diamondhollins7/cy68013-stm32-gpif-bridge/16-buses/hardware/FX2_STM32_GPIF_Bridge_Netlist.csv

Net | Ref | Pin | PinName
+3V3 | C13 | 1 | 1
+3V3 | C14 | 1 | 1
+3V3 | C15 | 1 | 1
+3V3 | C16 | 1 | 1
+3V3 | C17 | 1 | 1
+3V3 | C18 | 1 | 1
+3V3 | C19 | 1 | 1
+3V3 | C2 | 1 | 1
+3V3 | C20 | 1 | 1
+3V3 | C3 | 1 | 1
+3V3 | C33 | 1 | 1
+3V3 | C34 | 1 | 1
+3V3 | C35 | 1 | 1
+3V3 | C36 | 1 | 1
+3V3 | C37 | 1 | 1
+3V3 | C38 | 1 | 1
+3V3 | C39 | 1 | 1
+3V3 | FB2 | 1 | 1
+3V3 | FB3 | 1 | 1
+3V3 | J2 | 1 | VTref
+3V3 | JP2 | 1 | 1
+3V3 | R10 | 1 | 1
+3V3 | R11 | 1 | 1
+3V3 | R13 | 1 | 1
+3V3 | R14 | 1 | 1
+3V3 | R15 | 1 | 1
+3V3 | R2 | 1 | 1
+3V3 | R30 | 1 | 1
+3V3 | R50 | 1 | 1
+3V3 | R51 | 1 | 1
+3V3 | R52 | 1 | 1
+3V3 | TP2 | 1 | 1
+3V3 | U1 | 6 | VCC
+3V3 | U1 | 18 | VCC
+3V3 | U1 | 24 | VCC
+3V3 | U1 | 34 | VCC
+3V3 | U1 | 39 | VCC
+3V3 | U1 | 50 | VCC
+3V3 | U2 | 1 | A0
+3V3 | U2 | 8 | VCC
+3V3 | U3 | 2 | VOUT
+3V3 | U3 | 4 | TAB
+3V3 | U5 | 6 | VBAT
+3V3 | U5 | 11 | VDD_5
+3V3 | U5 | 28 | VDD_4
+3V3 | U5 | 50 | VDD_1
+3V3 | U5 | 75 | VDD_2
+3V3 | U5 | 100 | VDD_3
+3V3_FXA | C21 | 1 | 1
+3V3_FXA | C22 | 1 | 1
+3V3_FXA | C23 | 1 | 1
+3V3_FXA | FB2 | 2 | 2
+3V3_FXA | U1 | 10 | AVCC
+3V3_FXA | U1 | 14 | AVCC
+3V3_STA | C40 | 1 | 1
+3V3_STA | C41 | 1 | 1
+3V3_STA | FB3 | 2 | 2
+3V3_STA | U5 | 21 | VREF+
+3V3_STA | U5 | 22 | VDDA
+5V | C1 | 1 | 1
+5V | FB1 | 2 | 2
+5V | TP1 | 1 | 1
+5V | U3 | 3 | VIN
EE_SDA | JP1 | 2 | 2
EE_SDA | U2 | 5 | SDA
FD0 | RN1 | 1 | 1
FD0 | U1 | 25 | PB0/FD0
FD1 | RN1 | 2 | 2
FD1 | U1 | 26 | PB1/FD1
FD10 | RN3 | 3 | 3
FD10 | U1 | 54 | PD2/FD10
FD11 | RN3 | 4 | 4
FD11 | U1 | 55 | PD3/FD11
FD12 | RN4 | 1 | 1
FD12 | U1 | 56 | PD4/FD12
FD13 | RN4 | 2 | 2
FD13 | U1 | 1 | PD5/FD13
FD14 | RN4 | 3 | 3
FD14 | U1 | 2 | PD6/FD14
FD15 | RN4 | 4 | 4
FD15 | U1 | 3 | PD7/FD15
FD2 | RN1 | 3 | 3
FD2 | U1 | 27 | PB2/FD2
FD3 | RN1 | 4 | 4
FD3 | U1 | 28 | PB3/FD3
FD4 | RN2 | 1 | 1
FD4 | U1 | 29 | PB4/FD4
FD5 | RN2 | 2 | 2
FD5 | U1 | 30 | PB5/FD5
FD6 | RN2 | 3 | 3
FD6 | U1 | 31 | PB6/FD6
FD7 | RN2 | 4 | 4
FD7 | U1 | 32 | PB7/FD7
FD8 | RN3 | 1 | 1
FD8 | U1 | 52 | PD0/FD8
FD9 | RN3 | 2 | 2
FD9 | U1 | 53 | PD1/FD9
FX_CLKOUT | TP11 | 1 | 1
FX_CLKOUT | U1 | 5 | CLKOUT
FX_IFCLK | R12 | 1 | 1
FX_IFCLK | TP10 | 1 | 1
FX_IFCLK | U1 | 20 | IFCLK
FX_LED_A | D2 | A | A
FX_LED_A | R15 | 2 | 2
FX_LED_N | D2 | K | K
FX_LED_N | U1 | 41 | PA1/INT1#
FX_RESET_N | C12 | 1 | 1
FX_RESET_N | R10 | 2 | 2
FX_RESET_N | SW1 | 1 | 1
FX_RESET_N | U1 | 49 | RESET#
FX_WAKEUP | R11 | 2 | 2
FX_WAKEUP | U1 | 51 | WAKEUP
FX_XI | C10 | 1 | 1
FX_XI | U1 | 12 | XTALIN
FX_XI | Y1 | 1 | 1
FX_XO | C11 | 1 | 1
FX_XO | U1 | 11 | XTALOUT
FX_XO | Y1 | 2 | 2
GD0 | RN1 | 8 | 8
GD0 | U5 | 97 | PE0 D0
GD1 | RN1 | 7 | 7
GD1 | U5 | 98 | PE1 D1
GD10 | RN3 | 6 | 6
GD10 | U5 | 41 | PE10 D10
GD11 | RN3 | 5 | 5
GD11 | U5 | 42 | PE11 D11
GD12 | RN4 | 8 | 8
GD12 | U5 | 43 | PE12 D12
GD13 | RN4 | 7 | 7
GD13 | U5 | 44 | PE13 D13
GD14 | RN4 | 6 | 6
GD14 | U5 | 45 | PE14 D14
GD15 | RN4 | 5 | 5
GD15 | U5 | 46 | PE15 D15
GD2 | RN1 | 6 | 6
GD2 | U5 | 1 | PE2 D2
GD3 | RN1 | 5 | 5
GD3 | U5 | 2 | PE3 D3
GD4 | RN2 | 8 | 8
GD4 | U5 | 3 | PE4 D4
GD5 | RN2 | 7 | 7
GD5 | U5 | 4 | PE5 D5
GD6 | RN2 | 6 | 6
GD6 | U5 | 5 | PE6 D6
GD7 | RN2 | 5 | 5
GD7 | U5 | 38 | PE7 D7
GD8 | RN3 | 8 | 8
GD8 | U5 | 39 | PE8 D8
GD9 | RN3 | 7 | 7
GD9 | U5 | 40 | PE9 D9
GND | C1 | 2 | 2
GND | C10 | 2 | 2
GND | C11 | 2 | 2
GND | C12 | 2 | 2
GND | C13 | 2 | 2
GND | C14 | 2 | 2
GND | C15 | 2 | 2
GND | C16 | 2 | 2
GND | C17 | 2 | 2
GND | C18 | 2 | 2
GND | C19 | 2 | 2
GND | C2 | 2 | 2
GND | C20 | 2 | 2
GND | C21 | 2 | 2
GND | C22 | 2 | 2
GND | C23 | 2 | 2
GND | C3 | 2 | 2
GND | C30 | 2 | 2
GND | C31 | 2 | 2
GND | C32 | 2 | 2
GND | C33 | 2 | 2
GND | C34 | 2 | 2
GND | C35 | 2 | 2
GND | C36 | 2 | 2
GND | C37 | 2 | 2
GND | C38 | 2 | 2
GND | C39 | 2 | 2
GND | C4 | 2 | 2
GND | C40 | 2 | 2
GND | C41 | 2 | 2
GND | D1 | K | K
GND | D4 | K | K
GND | D5 | K | K
GND | J1 | 5 | GND
GND | J2 | 3 | GND
GND | J3 | 1 | GND
GND | J4 | 6 | GND
GND | R1 | 2 | 2
GND | R12 | 2 | 2
GND | R31 | 2 | 2
GND | R32 | 2 | 2
GND | R53 | 2 | 2
GND | R54 | 2 | 2
GND | SW1 | 2 | 2
GND | SW2 | 2 | 2
GND | TP3 | 1 | 1
GND | U1 | 4 | GND
GND | U1 | 7 | GND
GND | U1 | 13 | AGND
GND | U1 | 17 | AGND
GND | U1 | 19 | GND
GND | U1 | 21 | RESERVED
GND | U1 | 33 | GND
GND | U1 | 35 | GND
GND | U1 | 48 | GND
GND | U2 | 2 | A1
GND | U2 | 3 | A2
GND | U2 | 4 | VSS
GND | U2 | 7 | WP
GND | U3 | 1 | GND
GND | U4 | 2 | GND
GND | U5 | 10 | VSS_5
GND | U5 | 19 | VSSA
GND | U5 | 20 | VREF-
GND | U5 | 27 | VSS_4
GND | U5 | 49 | VSS_1
GND | U5 | 74 | VSS_2
GND | U5 | 99 | VSS_3
GPIF_ACK | J4 | 3 | ACK
GPIF_ACK | R53 | 1 | 1
GPIF_ACK | U1 | 8 | RDY0
GPIF_ACK | U5 | 17 | PC2 ACK
GPIF_DAV | J4 | 4 | DAV
GPIF_DAV | R54 | 1 | 1
GPIF_DAV | U1 | 9 | RDY1
GPIF_DAV | U5 | 18 | PC3 DAV
GPIF_NRD | J4 | 2 | nRD
GPIF_NRD | R51 | 2 | 2
GPIF_NRD | U1 | 37 | CTL1
GPIF_NRD | U5 | 16 | PC1 nRD
GPIF_NSYNC | J4 | 5 | nSYNC
GPIF_NSYNC | R52 | 2 | 2
GPIF_NSYNC | U1 | 38 | CTL2
GPIF_NSYNC | U5 | 33 | PC4 nSYNC
GPIF_NWR | J4 | 1 | nWR
GPIF_NWR | R50 | 2 | 2
GPIF_NWR | U1 | 36 | CTL0
GPIF_NWR | U5 | 15 | PC0 nWR
I2C_SCL | R13 | 2 | 2
I2C_SCL | U1 | 22 | SCL
I2C_SCL | U2 | 6 | SCL
I2C_SDA | JP1 | 1 | 1
I2C_SDA | R14 | 2 | 2
I2C_SDA | U1 | 23 | SDA
LED_HB | R33 | 1 | 1
LED_HB | U5 | 59 | PD12 LED
LED_HB_A | D4 | A | A
LED_HB_A | R33 | 2 | 2
LED_USR | R34 | 1 | 1
LED_USR | U5 | 60 | PD13 LED
LED_USR_A | D5 | A | A
LED_USR_A | R34 | 2 | 2
PWR_LED_A | D1 | A | A
PWR_LED_A | R2 | 2 | 2
STM_BOOT0 | JP2 | 2 | 2
STM_BOOT0 | R31 | 1 | 1
STM_BOOT0 | U5 | 94 | BOOT0
STM_BOOT1 | R32 | 1 | 1
STM_BOOT1 | U5 | 37 | PB2/BOOT1
STM_NRST | C32 | 1 | 1
STM_NRST | J2 | 5 | NRST
STM_NRST | R16 | 2 | 2
STM_NRST | R30 | 2 | 2
STM_NRST | SW2 | 1 | 1
STM_NRST | U5 | 14 | NRST
STM_NRST_CTL | R16 | 1 | 1
STM_NRST_CTL | U1 | 40 | PA0/INT0#
ST_XI | C30 | 1 | 1
ST_XI | U5 | 12 | OSC_IN
ST_XI | Y2 | 1 | 1
ST_XO | C31 | 1 | 1
ST_XO | U5 | 13 | OSC_OUT
ST_XO | Y2 | 2 | 2
SWCLK | J2 | 2 | SWCLK
SWCLK | U5 | 76 | PA14/SWCLK
SWDIO | J2 | 4 | SWDIO
SWDIO | U5 | 72 | PA13/SWDIO
UART_RX | J3 | 3 | RX
UART_RX | U5 | 69 | PA10/USART1_RX
UART_TX | J3 | 2 | TX
UART_TX | U5 | 68 | PA9/USART1_TX
USB_DM | J1 | 2 | D-
USB_DM | U1 | 16 | DMINUS
USB_DM | U4 | 3 | I/O2
USB_DM | U4 | 4 | I/O2
USB_DP | J1 | 3 | D+
USB_DP | U1 | 15 | DPLUS
USB_DP | U4 | 1 | I/O1
USB_DP | U4 | 6 | I/O1
USB_SHIELD | C4 | 1 | 1
USB_SHIELD | J1 | 6 | SHIELD
USB_SHIELD | R1 | 1 | 1
VBUS_CONN | F1 | 1 | 1
VBUS_CONN | J1 | 1 | VBUS
VBUS_CONN | U4 | 5 | VBUS
VBUS_F | F1 | 2 | 2
VBUS_F | FB1 | 1 | 1
(no connect) | J1 | 4 | ID
(no connect) | U1 | 42 | PA2/SLOE
(no connect) | U1 | 43 | PA3/WU2
(no connect) | U1 | 44 | PA4/FIFOADR0
(no connect) | U1 | 45 | PA5/FIFOADR1
(no connect) | U1 | 46 | PA6/PKTEND
(no connect) | U1 | 47 | PA7/FLAGD
(no connect) | U5 | 73 | NC
(no connect) | U5 | 34 | PC5
(no connect) | U5 | 63 | PC6
(no connect) | U5 | 64 | PC7
(no connect) | U5 | 65 | PC8
(no connect) | U5 | 66 | PC9
(no connect) | U5 | 78 | PC10
(no connect) | U5 | 79 | PC11
(no connect) | U5 | 80 | PC12
(no connect) | U5 | 7 | PC13
(no connect) | U5 | 8 | PC14
(no connect) | U5 | 9 | PC15
(no connect) | U5 | 81 | PD0
(no connect) | U5 | 82 | PD1
(no connect) | U5 | 83 | PD2
(no connect) | U5 | 84 | PD3
(no connect) | U5 | 85 | PD4
(no connect) | U5 | 86 | PD5
(no connect) | U5 | 87 | PD6
(no connect) | U5 | 88 | PD7
(no connect) | U5 | 55 | PD8
(no connect) | U5 | 56 | PD9
(no connect) | U5 | 57 | PD10
(no connect) | U5 | 58 | PD11
(no connect) | U5 | 61 | PD14
(no connect) | U5 | 62 | PD15
(no connect) | U5 | 23 | PA0
(no connect) | U5 | 24 | PA1
(no connect) | U5 | 25 | PA2
(no connect) | U5 | 26 | PA3
(no connect) | U5 | 29 | PA4
(no connect) | U5 | 30 | PA5
(no connect) | U5 | 31 | PA6
(no connect) | U5 | 32 | PA7
(no connect) | U5 | 67 | PA8
(no connect) | U5 | 70 | PA11
(no connect) | U5 | 71 | PA12
(no connect) | U5 | 77 | PA15
(no connect) | U5 | 35 | PB0
(no connect) | U5 | 36 | PB1
(no connect) | U5 | 89 | PB3
(no connect) | U5 | 90 | PB4
(no connect) | U5 | 91 | PB5
(no connect) | U5 | 92 | PB6
(no connect) | U5 | 93 | PB7
(no connect) | U5 | 95 | PB8
(no connect) | U5 | 96 | PB9
(no connect) | U5 | 47 | PB10
(no connect) | U5 | 48 | PB11
(no connect) | U5 | 51 | PB12
(no connect) | U5 | 52 | PB13
(no connect) | U5 | 53 | PB14
(no connect) | U5 | 54 | PB15
