diamondhollins7/cy68013-stm32-gpif-bridge/8-bus/hardware/FX2_STM32_GPIF8_Bridge_Schematic.pdf

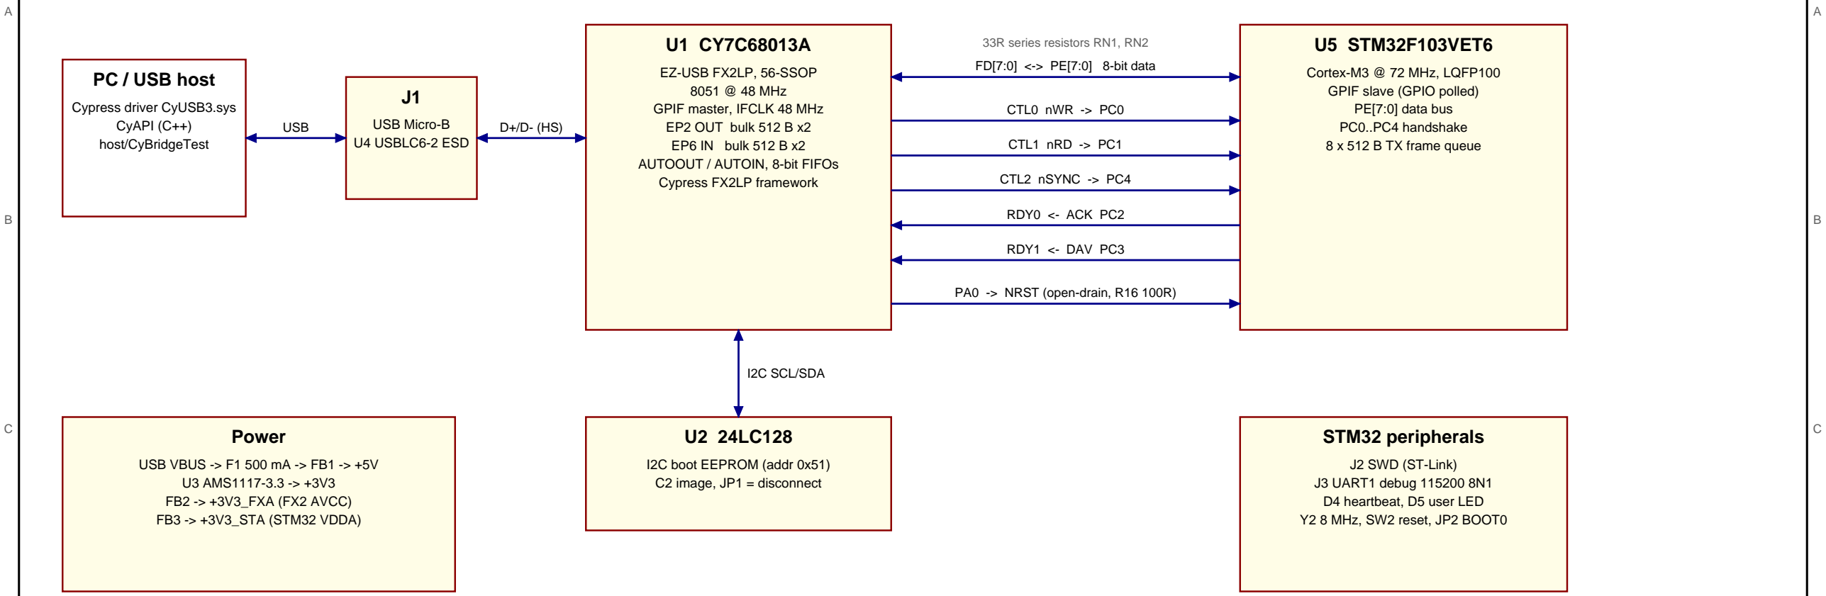
[picture p10: figure]
PC / USB host; Cypress driver CyUSB3.sys CyAPI (C++) host/CyBridgeTest; USB Micro-B U4 USBLC6-2 ESD; EZ-USB FX2LP, 56-SSOP 8051 @ 48 MHz GPIF master, IFCLK 48 MHz EP2 OUT bulk 512 B x2 EP6 IN bulk 512 B x2 AUTOOUT / AUTOIN, 8-bit FIFOs Cypress FX2LP framework; U5 STM32F103VET6; Cortex-M3 @ 72 MHz, LQFP100 GPIF slave (GPIO polled) PE[7:0] data bus PC0..PC4 handshake 8 x 512 B TX frame queue; I2C boot EEPROM (addr 0x51) C2 image, JP1 = disconnect; Power; USB VBUS -> F1 500 mA -> FB1 -> +5V U3 AMS1117-3.3 -> +3V3 FB2 -> +3V3_FXA (FX2 AVCC) FB3 -> +3V3_STA (STM32 VDDA); STM32 peripherals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

D | D
E | E
F | F

PROJECT

## FX2LP - STM32F103 GPIF USB Bridge (8-bit)

SHEET TITLE

## Overview & GPIF interface

DATE
2026-10-02

REV

SHEET

FX2LP (CY7C68013A-56PVXC) <-> STM32F103VET6 : USB 2.0 High-Speed bridge over an 8-bit GPIF bus

## GPIF interconnect

Signal | FX2 pin (56-SSOP) | Net | STM32 pin (LQFP100) | Dir | Function
FD0..FD7 | PB0..PB7 : 25..32 | FD0..7 / GD0..7 | PE0..PE7 : 97,98,1,2,3,4,5,38 | <-> | 8-bit data bus (USB byte stream)
nWR | CTL0 : 36 | GPIF_NWR | PC0 : 15 | -> | FX2 write strobe, low = data valid
nRD | CTL1 : 37 | GPIF_NRD | PC1 : 16 | -> | FX2 read strobe, low = STM32 must drive bus
nSYNC | CTL2 : 38 | GPIF_NSYNC | PC4 : 33 | -> | low pulse = drop partial frames (FIFO reset)
ACK | RDY0 : 8 | GPIF_ACK | PC2 : 17 | <- | byte handshake (4-phase)
DAV | RDY1 : 9 | GPIF_DAV | PC3 : 18 | <- | STM32 has a 512-byte frame for the PC
NRST | PA0 : 40 | STM_NRST_CTL | NRST : 14 | -> | FX2 can reset the STM32 (vendor req. 0xB1)

### Design notes

1. One GPIF transaction = one byte, fully handshaked:
the STM32 serves the bus by GPIO polling, no timing constraint.
2. USB data never passes through the 8051 (AUTOOUT/AUTOIN FIFOs).
3. All transfers are 512-byte frames (one HS packet).
4. VID/PID 04B4:1004 (Cypress driver) is for development only.
5. Decouple every VCC/VDD pin with 100 nF placed at the pin.
6. USB D+/D-: 90 ohm differential, short, no stubs, no vias
if possible; keep the 24 MHz crystal next to U1.
7. Keep FD/CTL/RDY traces < 10 cm, series resistors at U1.
8. Unused FX2 PA2..PA7 and PD0..PD7 are driven low by firmware.

## USB 2.0 connector

J1

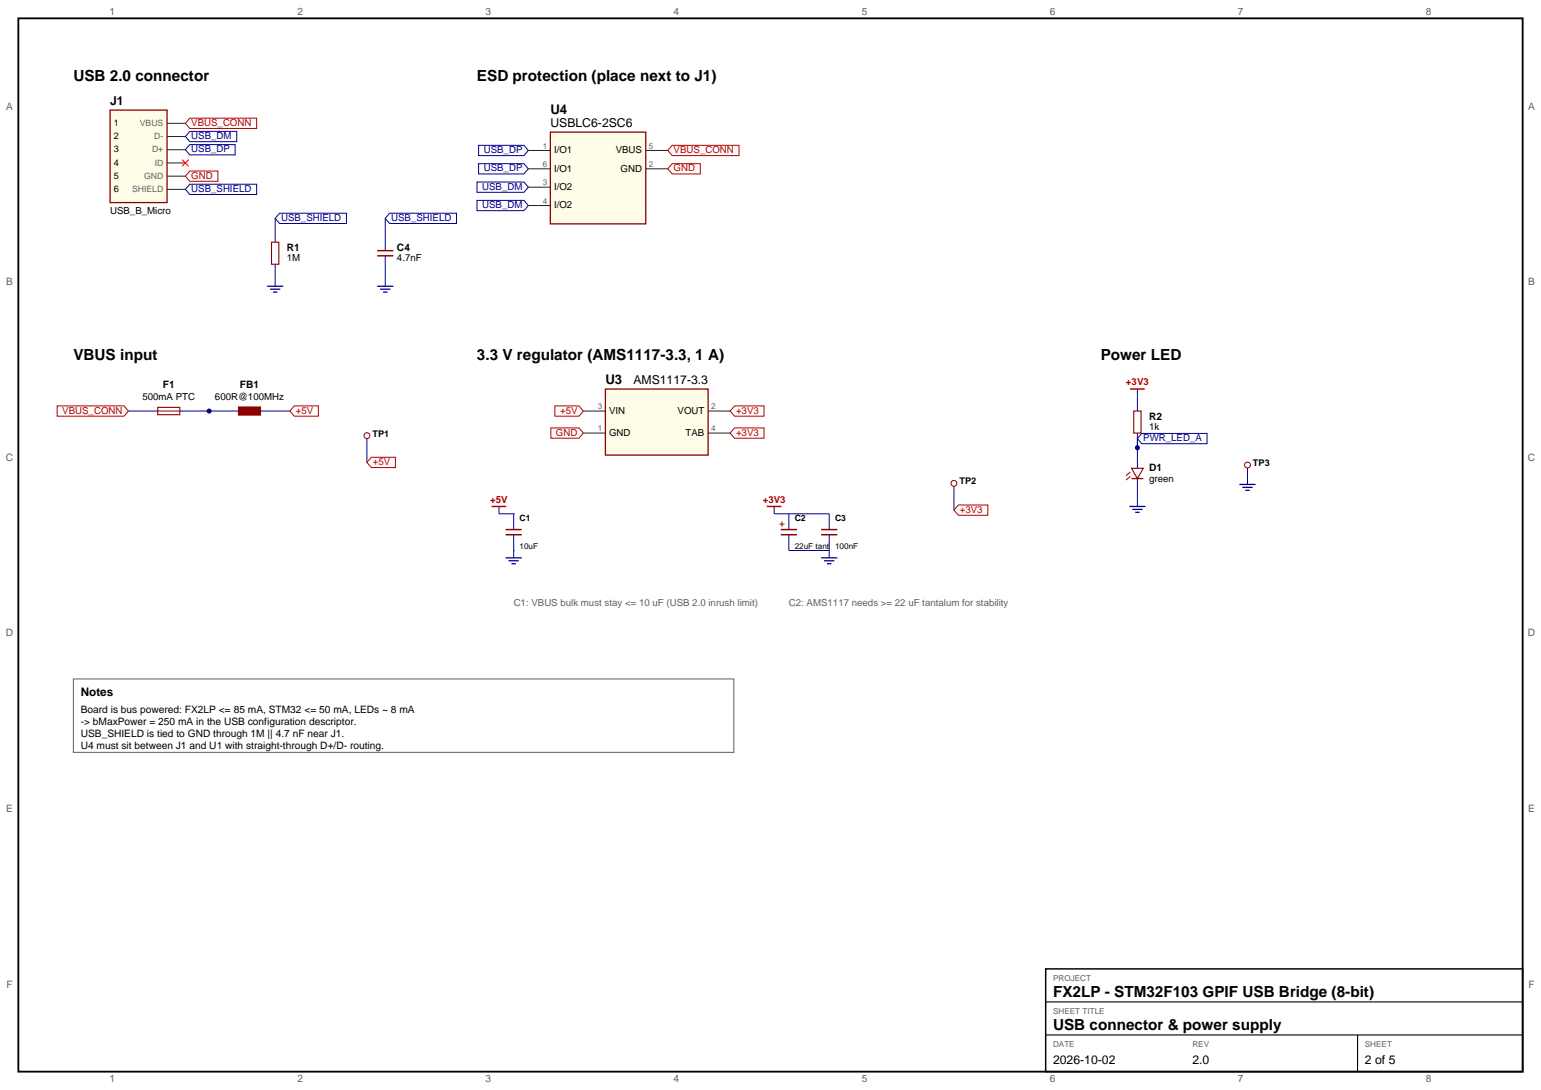
[picture p11: page 2]

ESD protection (place next to J1)

Notes
Board is bus powered: FX2LP <= 85 mA, STM32 <= 50 mA, LEDs ~ 8 mA
-> bMaxPower = 250 mA in the USB configuration descriptor.
USB_SHIELD is tied to GND through 1M || 4.7 nF near J1.
U4 must sit between J1 and U1 with straight-through D+/D- routing.

PROJECT
FX2LP - STM32F103 GPIF USB Bridge (8-bit)
USB connector & power supply

U1 | CY7C68013A-56PVXC

## 24 MHz crystal

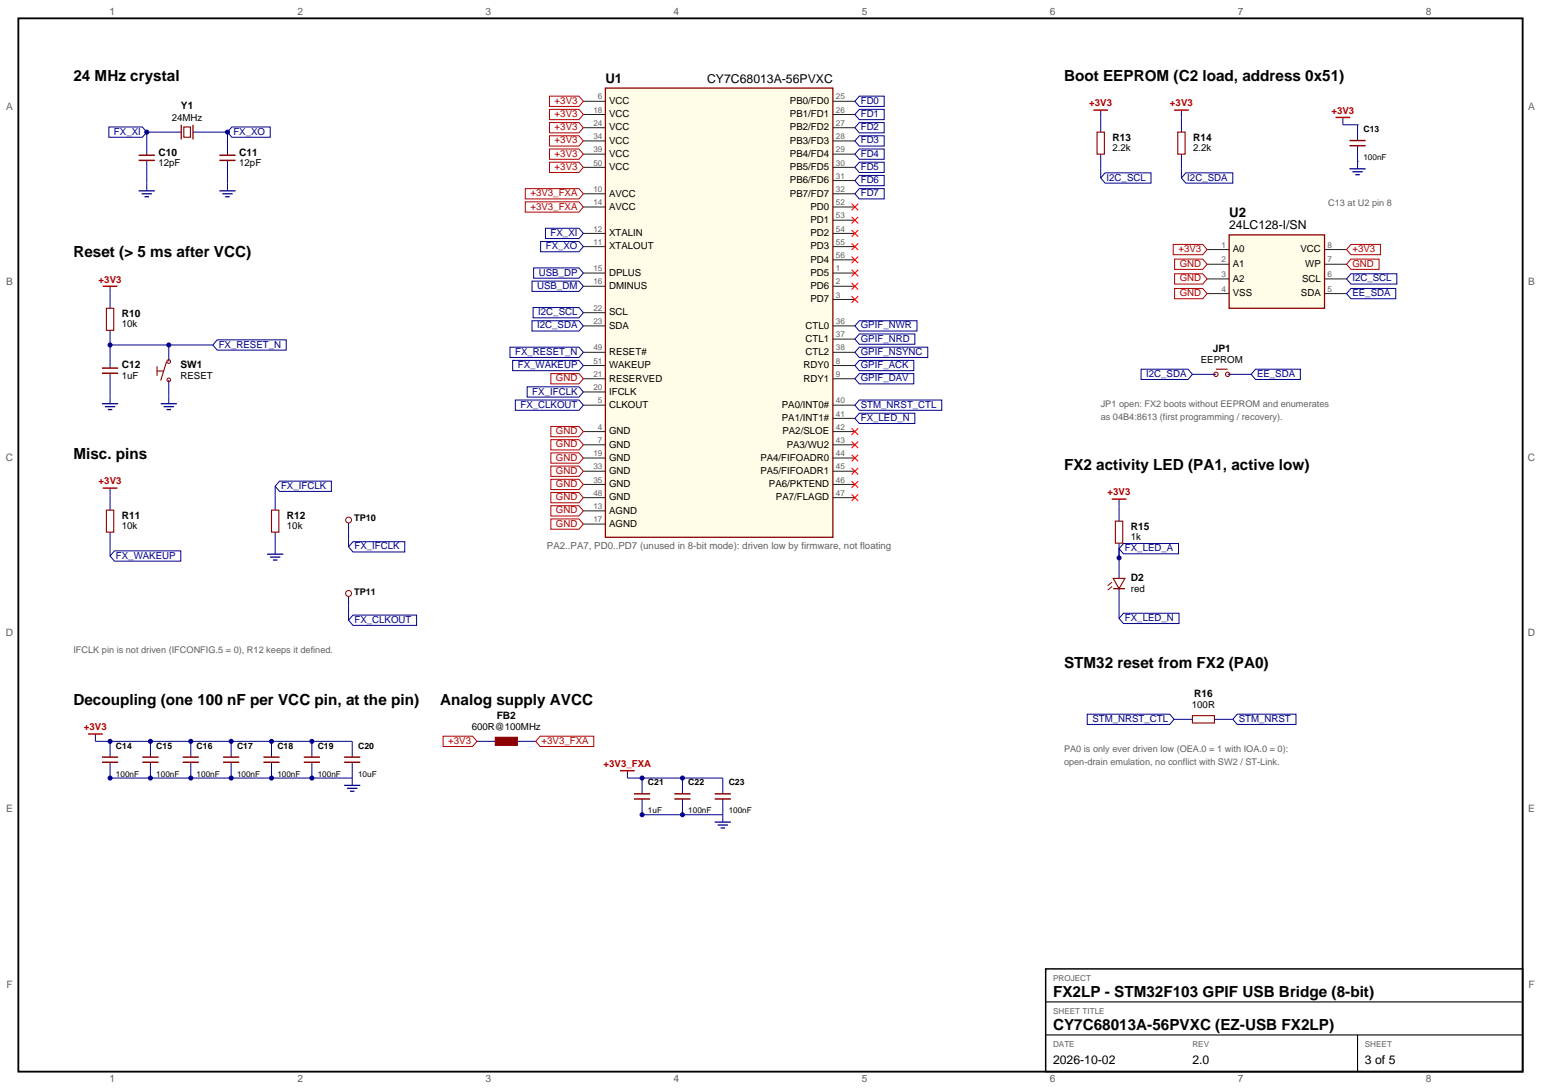
[picture p12: page 3]

Boot EEPROM (C2 load, address 0x51)

Reset (> 5 ms after VCC)

JP1 open: FX2 boots without EEPROM and enumerates
as 04B4:8613 (first programming / recovery).

FX2 activity LED (PA1, active low)

PA2..PA7, PD0..PD7 (unused in 8-bit mode): driven low by firmware, not floating

IFCLK pin is not driven (IFCONFIG.5 = 0), R12 keeps it defined.

Decoupling (one 100 nF per VCC pin, at the pin)

PA0 is only ever driven low (OEA.0 = 1 with IOA.0 = 0):
open-drain emulation, no conflict with SW2 / ST-Link.

PROJECT
FX2LP - STM32F103 GPIF USB Bridge (8-bit)
CY7C68013A-56PVXC (EZ-USB FX2LP)

U5 | STM32F103VET6

## 8 MHz crystal (HSE)

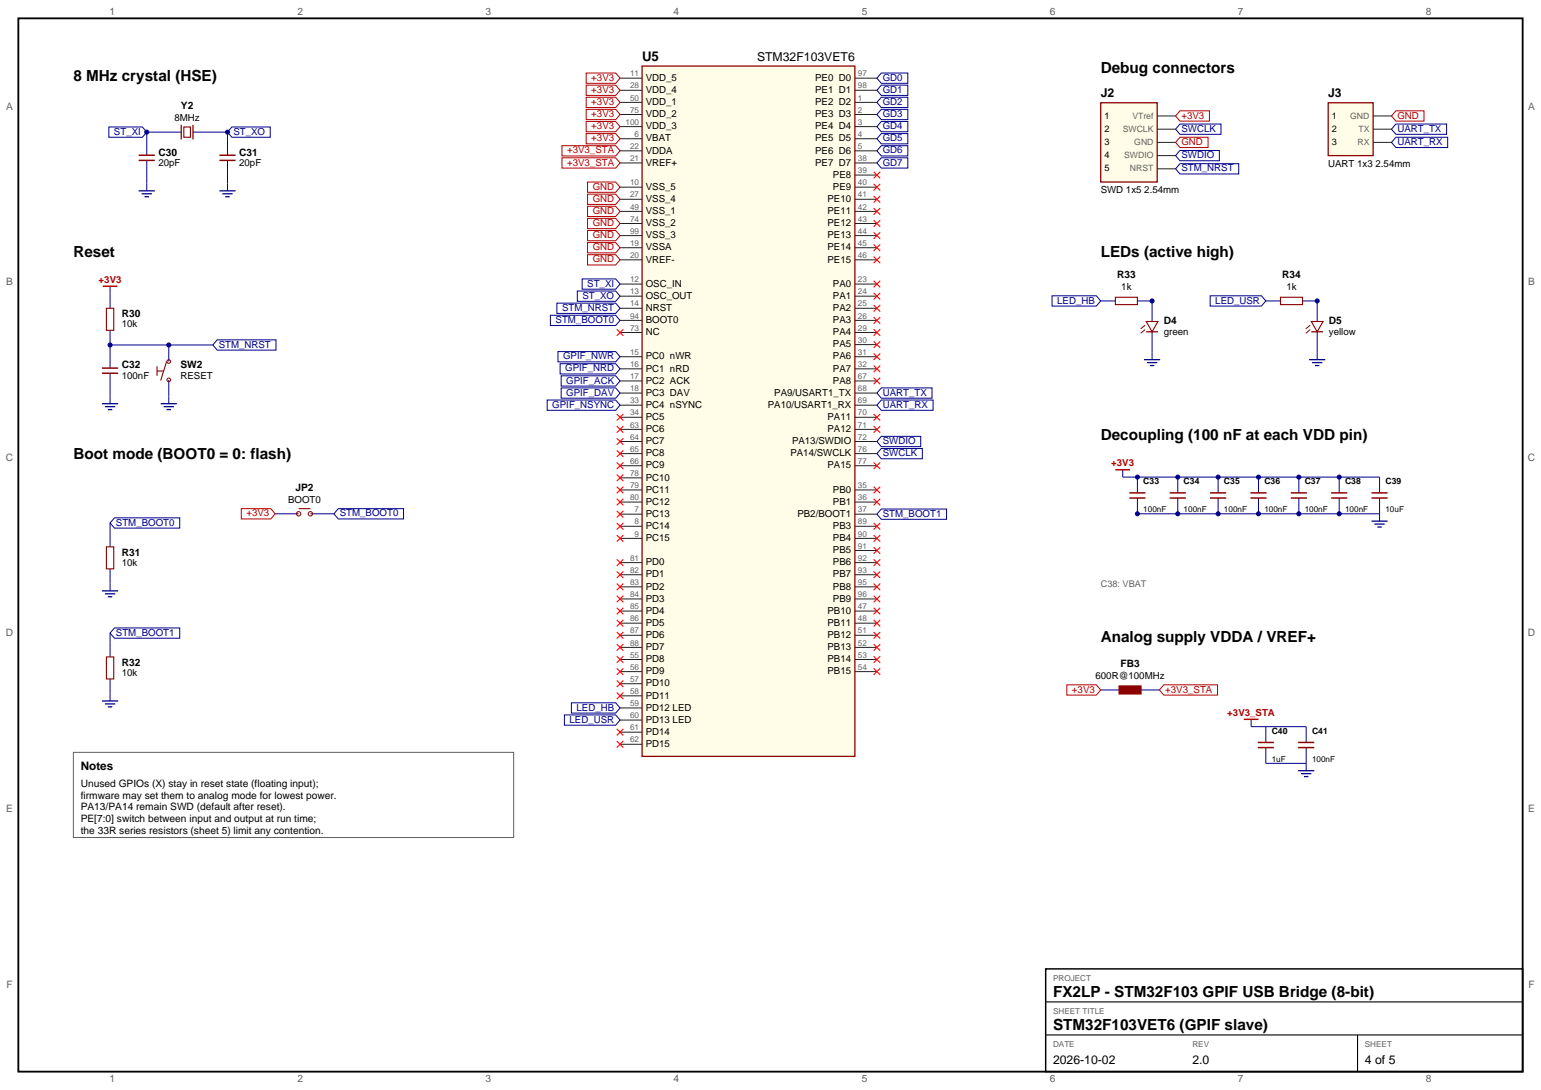
[picture p13: page 4]

Decoupling (100 nF at each VDD pin)

Analog supply VDDA / VREF+

Notes
Unused GPIOs (X) stay in reset state (floating input);
firmware may set them to analog mode for lowest power.
PA13/PA14 remain SWD (default after reset).
PE[7:0] switch between input and output at run time;
the 33R series resistors (sheet 5) limit any contention.

PROJECT
FX2LP - STM32F103 GPIF USB Bridge (8-bit)
STM32F103VET6 (GPIF slave)

A | A
B | B
C | C
D | D
E | E
F | F

PROJECT

## FX2LP - STM32F103 GPIF USB Bridge (8-bit)

## GPIF interconnect & handshake timing

## Data bus series resistors (place close to U1)

RN1 4x33R
1 | 8
FD0 | GD0
2 | 7
FD1 | GD1
3 | 6
FD2 | GD2
4 | 5
FD3 | GD3

RN2 4x33R
1 | 8
FD4 | GD4
2 | 7
FD5 | GD5
3 | 6
FD6 | GD6
4 | 5
FD7 | GD7

## Handshake line bias (defined levels while a chip is in reset)

R50
10k

+3V3

GPIF_NWR

R51
10k

+3V3

GPIF_NRD

R52
10k

+3V3

GPIF_NSYNC

R53
10k

GPIF_ACK

R54
10k

GPIF_DAV

Pull-ups keep strobes inactive, pull-downs keep ACK/DAV = 0 (FX2 never sees 'ready' from an STM32 that is in reset).

## Logic analyser header

J4

1x6 2.54mm

1 | nWR | GPIF_NWR
2 | nRD | GPIF_NRD
3 | ACK | GPIF_ACK
4 | DAV | GPIF_DAV
5 | nSYNC | GPIF_NSYNC
6 | GND | GND

## Bus mapping

FX2 pin | FX2 signal | net (FX2 / STM32) | STM32 pin
25 | PB0 / FD0 | FD0 / GD0 | 97 PE0
26 | PB1 / FD1 | FD1 / GD1 | 98 PE1
27 | PB2 / FD2 | FD2 / GD2 | 1 PE2
28 | PB3 / FD3 | FD3 / GD3 | 2 PE3
29 | PB4 / FD4 | FD4 / GD4 | 3 PE4
30 | PB5 / FD5 | FD5 / GD5 | 4 PE5
31 | PB6 / FD6 | FD6 / GD6 | 5 PE6
32 | PB7 / FD7 | FD7 / GD7 | 38 PE7

## FX2 -> STM32 byte write (GPIF FIFO-write waveform, 1 transaction)

FD[7:0] | byte n (FX2 drives) | byte n+1 (after NEXT)

### nWR

### ACK

| S1: nWR=0, wait ACK
STM32 latches PE, ACK=1
| | S2: NEXT, nWR=1 STM32 ACK=0 -> IDLE

## STM32 -> FX2 byte read (GPIF FIFO-read waveform, 1 transaction)

### nRD

FD[7:0] | STM32 drives byte

### ACK

S0: nRD=0, wait ACK
| data valid, ACK=1

S1: sample
S2: nRD=1, STM32 releases bus

ACK=0 -> IDLE

### Protocol

DAV (RDY1) is high while the STM32 has a 512-byte frame queued. FX2 reads one USB packet per GPIF trigger (512 bytes HS, 64 bytes FS) only when DAV = 1 and the EP6 FIFO is not full.
FX2 writes one EP2 packet per trigger (byte count transactions).
nSYNC low (1 ms): issued after power-up, SET_CONFIGURATION and vendor request 0xB1 - STM32 drops partial frames on both sides.
All RDY inputs are synchronised by the FX2 (IFCONFIG.ASYNC = 1), so no setup/hold requirement exists on the STM32 side.
